antonio-mariano/caffeine-content/firmware/caffeine-content/MakeCoffe.cpp

#include <Arduino.h>
#include <math.h>
#include "MakeCoffe.h"
#include "Display.h"

#define BUTTON_PRESS_TIME 500
#define BUTTON_INTERRUPT_MIN_TIME 500

long dead_time, over_time;   // ms
long flow_time;              // ms
float flow_rate;             // mL/ms
float used_cfi, used_vol;    // mg , mL
float total_cfi;             // mg

float desired_cfi, desired_vol;

enum State {
  state_waiting,
  state_start,
  state_dead_time,
  state_active_time,
  state_over_time
};
State current_state = state_waiting;


float vol2cfi(float vol){
  return total_cfi * (1 - exp(-vol/LAMBDA));
}

float cfi2vol(float cfi){
  return -LAMBDA * log(1 - cfi/total_cfi);
}

void setupCoffe()
{
  dead_time = DEAD_TIME*1000.0; // seconds to ms
  over_time = OVER_TIME*1000.0; // seconds to ms
  flow_rate = FLOW_RATE/1000.0; // mL/s to mL/ms

  total_cfi = CAFFEINE_30 / (1 - exp(-30/LAMBDA)); //TODO pode ficar num setup
  used_cfi = 0.0f;
  used_vol = 0.0f;
}

// Turning off the machine as soon as it enters over_time will produce a volume equal to over_time
// So, the minimum volume is the volume produced during over_time
// This function convers that min_vol to caffeine
int minimumCfi(){
  float min_vol = over_time * flow_rate; 
  return (int)(vol2cfi(used_vol + min_vol) - used_cfi + 1.0); //ceil round
}

int maximumCfi(){
  return (int)(CAFFEINE_30 - used_cfi); //floor round
}


void newCoffe(const String& args) {

  if (args.length() == 0) {
    Serial.println("Usage: coffe <cafeine mg>");
    return;
  }

  desired_cfi = args.toFloat();

  if((int)desired_cfi > maximumCfi()){
    Serial.printf("Available cafeine in the capsule: %d\n", maximumCfi());
    return;
  }

  if((int)desired_cfi < minimumCfi()){
    Serial.printf("Minimum caffeine possible: %d mg (because we need flow-time >= over-time)\n", minimumCfi());
    return;
  }

  desired_vol = cfi2vol(used_cfi + desired_cfi) - used_vol;
  flow_time = desired_vol / flow_rate; //ms

  Serial.printf("Caffeine quantity: %.1f mg\nNext vol: %.3f mL\nFlow time: %d ms\n\n", desired_cfi, desired_vol, flow_time);
  current_state = state_start; // Starts the process
}

void newCapsule(){
  //Or call setupCoffe() just for these 2 resets
  used_cfi = 0.0f;
  used_vol = 0.0f;

  Serial.println("New capsule");
}

float extractedCfi(long initial_time){
  float extracted_vol = flow_rate * (millis() - initial_time);
  float extracted_cfi = vol2cfi(used_vol + extracted_vol) - used_cfi;
  return extracted_cfi;
}
void loopCoffe() {

  if(current_state == state_waiting) return;
  static long time = 0, button = 0;
  static long active_time;
  static long extracted_time;


  // Presses the button if the counter is active
  digitalWrite(SOLENOID_PIN, millis() - button < BUTTON_PRESS_TIME ? HIGH : LOW);
  
  if(current_state == state_start){
    if(flow_time < over_time)
      active_time = 0;
    else
      active_time = flow_time - over_time;

    time = millis();
    Serial.print("Start! go to dead_time\n");
    button = millis(); // Starts the button counter, pressing it for 250 ms
    current_state = state_dead_time;
  }

  if(current_state == state_dead_time){

    // Divides dead_time in five equal partes to write "COFFEE"
    int frac = (5*(millis() - time)) / dead_time;
    switch(frac){
      case 0: showLetters("CO"); break;
      case 1: showLetters("OF"); break;
      case 2: showLetters("FF"); break;
      case 3: showLetters("FE"); break;
      case 4: showLetters("EE"); break;
    }

    if(millis() - time > dead_time){ // change to state_active_time
      time = millis();
      Serial.printf("Changing to state_active_time\n");
      current_state = state_active_time;
      extracted_time = millis();
    }
  }
    
  if(current_state == state_active_time){

    showNumber((int) extractedCfi(extracted_time));

    if(millis() - time > active_time){ // change to state_over_time
      time = millis();
      button = millis(); // Starts the button counter, pressing it for 250 ms
      Serial.print("Changing to state state_over_time\n");
      current_state = state_over_time;
    }
  }

  if(current_state == state_over_time){

    showNumber((int) extractedCfi(extracted_time));

    if(millis() - time > over_time){
      Serial.print("End over-time => Coffe is ready\n");

      // Update vars for the next coffe, as if the current coffe making process has already ended
      used_cfi += desired_cfi;
      used_vol += desired_vol;
      current_state = state_waiting;
    }
  }

}
