antonio-mariano/caffeine-content/firmware/caffeine-content/Communication.cpp

#include <Arduino.h>
#include "Communication.h"
#include "MakeCoffe.h"
#include "Display.h"

String inputBuffer = "";

bool handleSerialInput() {
  while (Serial.available() > 0) {
    char c = Serial.read();

    if (c == '\n' || c == '\r') {
      if (inputBuffer.length() > 0) {
        return true;
      }
    } else {
      inputBuffer += c;
    }
  }
  return false;
}

void loopSerialInput() {

  if(!handleSerialInput())  return;
  
  String trimmed = inputBuffer;
  trimmed.trim();
  inputBuffer = "";

  int firstSpace = trimmed.indexOf(' ');
  String command, args;

  if (firstSpace == -1) {
    command = trimmed;
    args = "";
  } else {
    command = trimmed.substring(0, firstSpace);
    args = trimmed.substring(firstSpace + 1);
  }

  if (command.equalsIgnoreCase("coffe")) {
    newCoffe(args);
  }

  if (command.equalsIgnoreCase("capsule")) {
    newCapsule();
  }

  if (command.equalsIgnoreCase("number")) {
    showNumber(args.toInt());
  }

  if (command.equalsIgnoreCase("letters")) {
    showLetters(args);
  }

}
