antonio-mariano/caffeine-content/(commit log)

2026-02-23 Button code (in Display.cpp temporary
2026-02-23 Add buttons logic in dedicated files. run... functions renamed to loop...
2026-02-23 Decremented anode pins to make space to the new possibleValue LED, that indicates if the current displayed value is possible to make coffe
2026-02-23 schematic added
2026-02-24 Edit schematic and coffe machine params
2026-02-24 Edit schematic
2026-02-25 added circuit photo
2026-02-25 Update README with circuit image
    Add circuit image
